tingtt/business-card/README.md

# taku-ting's business cards

- [modu-tone](./modu-tone/): modu-tone PCB business card
