tingtt/business-card/case/case.3mf

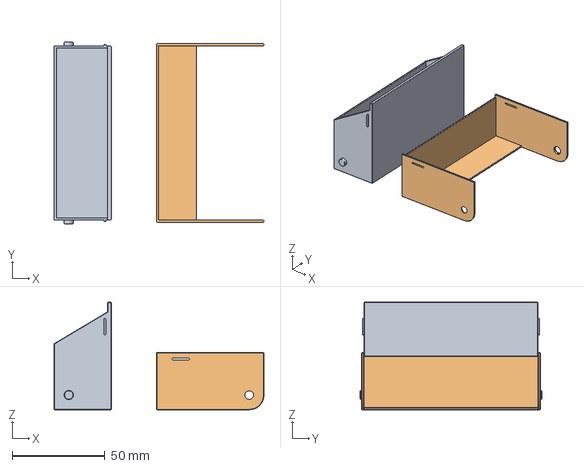
[picture p1: CAD file, 2026-08-08]
case/case.3mf
113.5 x 98.2 x 58.2 mm
case.stl
cover.stl
