tingtt/business-card/holder/card_holder.3mf

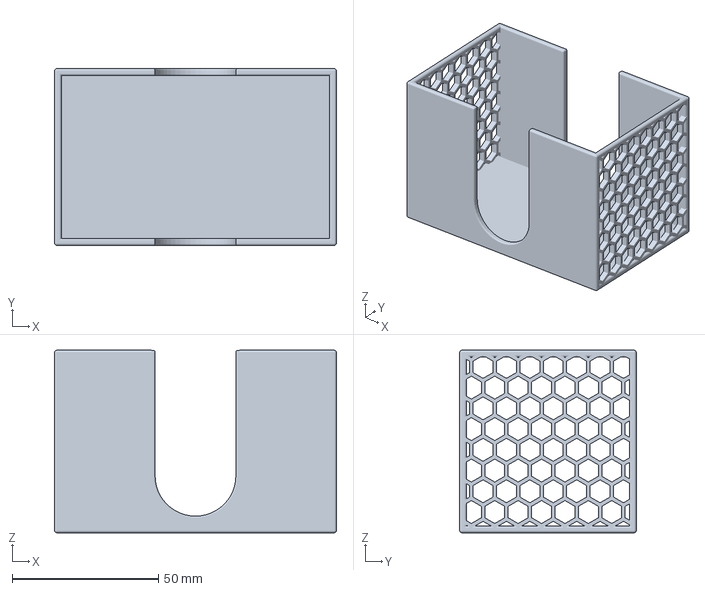
[picture p2: CAD file, 2026-07-26]
holder/card_holder.3mf
96.4 x 60.4 x 62.4 mm
