tingtt/business-card/modu-tone/business-card.step

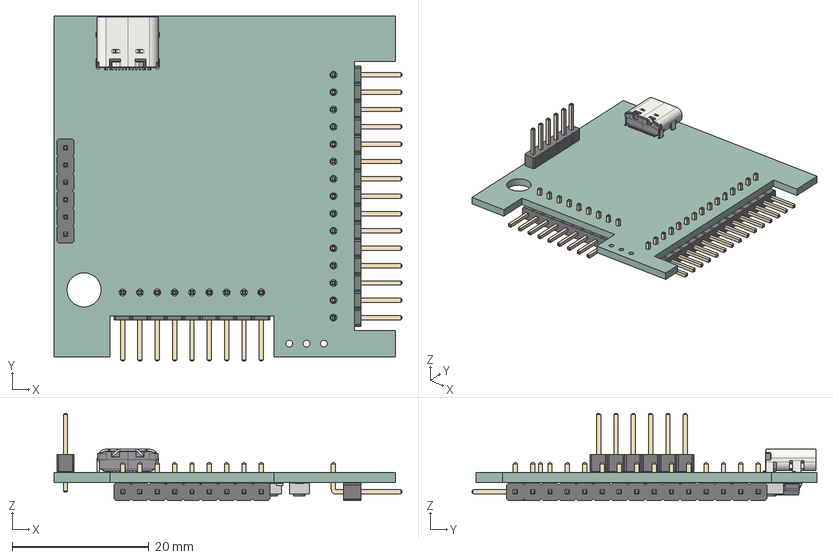
[picture p3: CAD file, 2026-07-18]
modu-tone/business-card.step
51.0 x 50.5 x 12.8 mm
PinHeader_1x06_P2.54mm_Vertical
USB_C_Receptacle_GCT_USB4105-xx-A_16P_TopMnt_Horizontal
C_0402_1005Metric x 16
SOT-223
USON-10_2.5x1.0mm_P0.5mm
D_SOD-523
R_0402_1005Metric x 11
Crystal_SMD_3225-4Pin_3.2x2.5mm
SOIC-8_5.3x5.3mm_P1.27mm
PinHeader_1x15_P2.54mm_Horizontal
TS-1088R-02026 x 2
QFN-56-1EP_7x7mm_P0.4mm_EP3.2x3.2mm
PinHeader_1x09_P2.54mm_Horizontal
base_PCB
