tingtt/business-card/modu-tone/business-card.kicad_pcb

## KiCad design modu-tone/business-card.kicad_pcb (2026-07-18)

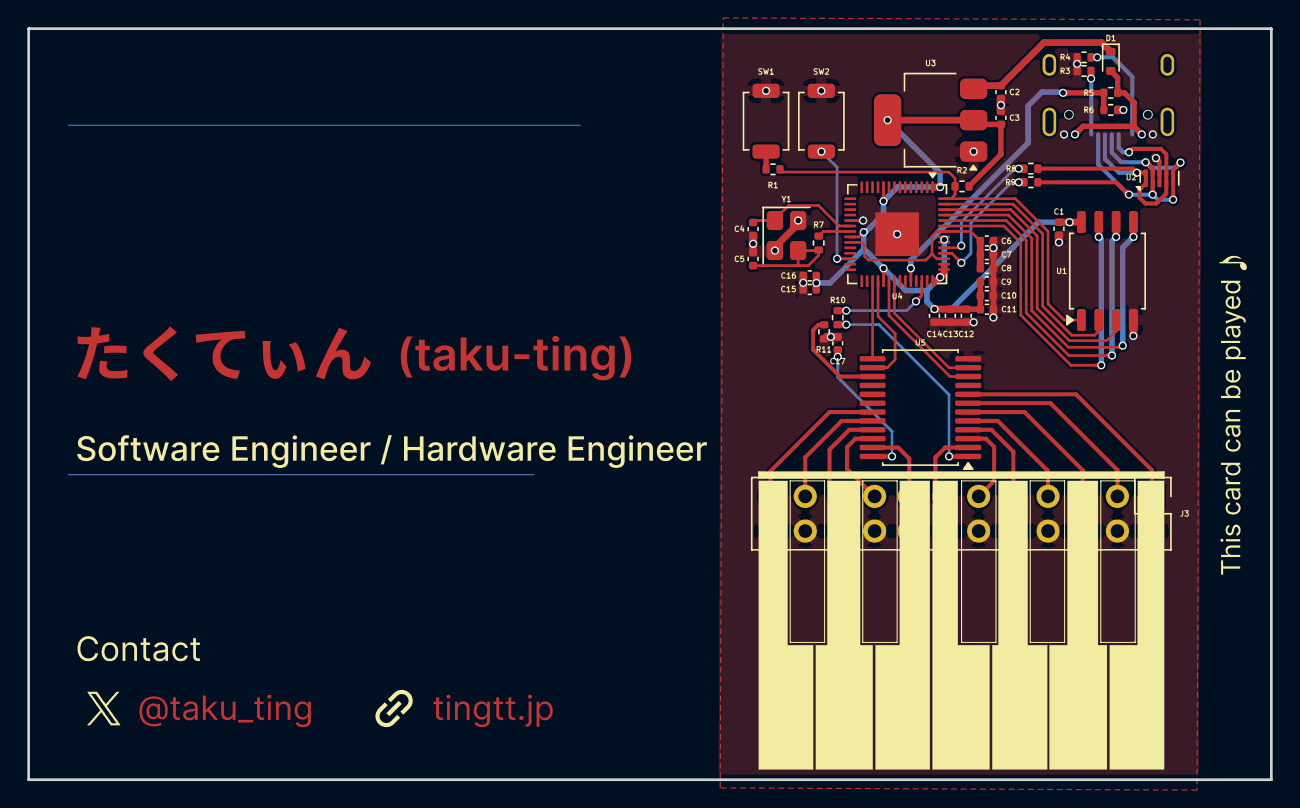
[picture p4: board business-card.kicad_pcb from above]

Board: 2 copper layers, 91.0 x 55.0 mm, 39 parts (1 on the bottom side), 43 nets.

Parts:
C1, C7, C10: 1u; C_0402_1005Metric
C2, C3: 10u; C_0402_1005Metric
C4, C5: 27p; C_0402_1005Metric
C6, C8, C9, C11, C12, C13, C14, C15, C16, C17: 100n; C_0402_1005Metric
D1: RB521S30T1G; D_SOD-523
J1: USB_C_Receptacle_USB2.0_16P; USB_C_Receptacle_HRO_TYPE-C-31-M-12
J3: Conn_02x12; PinHeader_2x12_P2.54mm_Vertical
R1, R7: 1k; R_0402_1005Metric
R2, R11: 10k; R_0402_1005Metric
R3, R4: 5.1k; R_0402_1005Metric
R5: 5.6k; R_0402_1005Metric
R6: 10K; R_0402_1005Metric
R8, R9: 27; R_0402_1005Metric
R10: 100; R_0402_1005Metric
SW1, SW2: TS-1088R-020; SW_SPST_TS-1088-xR020
U1: W25Q128JVS; SOIC-8_5.3x5.3mm_P1.27mm
U2: TPD4E05U06DQAR; USON-10_2.5x1.0mm_P0.5mm
U3: NCP1117LPST33T3G; SOT-223-3_TabPin2
U4: RP2040; QFN-56-1EP_7x7mm_P0.4mm_EP3.2x3.2mm
U5: CD74HC4067PW; SSOP-24_5.3x8.2mm_P0.65mm
Y1: 12MHz 18pF; Crystal_SMD_3225-4Pin_3.2x2.5mm

Connections:
+1V1: C6.1, C7.1, C8.1, U4.23 (DVDD), U4.45 (VREG_VOUT), U4.50 (DVDD)
+3V3: C1.1, C3.1, C9.1, C10.1, C11.1, C12.1, C13.1, C14.1, C15.1, C16.1, R2.2, U1.8 (VCC), U3.2 (VO), U4.1 (IOVDD), U4.10 (IOVDD), U4.22 (IOVDD), U4.33 (IOVDD), U4.42 (IOVDD), U4.43 (ADC_AVDD), U4.44 (VREG_IN), U4.48 (USB_VDD), U4.49 (IOVDD)
+5V: C2.1, D1.1 (K), U3.3 (VI)
/Key scan ADC: R10.2, U4.40 (GPIO28_ADC2)
/Key scan MUX S0: U4.31 (GPIO20), U5.13 (S3)
/Key scan MUX S1: U4.32 (GPIO21), U5.14 (S2)
/Key scan MUX S2: U4.34 (GPIO22), U5.10 (S0)
/Key scan MUX S3: U4.35 (GPIO23), U5.11 (S1)
GND: C1.2, C2.2, C3.2, C4.2, C5.2, C6.2, C7.2, C8.2, C9.2, C10.2, C11.2, C12.2, C13.2, C14.2, C15.2, C16.2, C17.1, J1.A1 (GND), J1.A12 (GND), J1.B1 (GND), J1.B12 (GND), J3.2, J3.4, J3.6, J3.8, J3.10, J3.12, J3.14, J3.16, J3.18, J3.20, J3.22, J3.24, R3.1, R4.1, R6.2, R11.1, SW1.1, SW2.1, U1.4 (GND), U2.3 (GND), U2.8 (GND), U3.1 (GND), U4.19 (TESTEN), U4.57 (GND), U5.12 (GND), Y1.2, Y1.4
unnamed: C5.1, R7.1, Y1.3
unnamed: J1.A5 (CC1), R3.2
unnamed: J1.B5 (CC2), R4.2
unnamed: J3.1, U5.8 (I1)
unnamed: J3.3, U5.7 (I2)
unnamed: J3.5, U5.6 (I3)
unnamed: J3.7, U5.5 (I4)
unnamed: J3.9, U5.4 (I5)
unnamed: J3.11, U5.3 (I6)
unnamed: J3.13, U5.2 (I7)
unnamed: J3.15, U5.23 (I8)
unnamed: J3.17, U5.22 (I9)
unnamed: J3.19, U5.21 (I10)
unnamed: J3.21, U5.20 (I11)
unnamed: J3.23, U5.19 (I12)
unnamed: R1.2, SW1.2
unnamed: SW2.2, U4.26 (RUN)
unnamed: R9.1, U4.46 (USB_DM)
unnamed: R8.2, U4.47 (USB_DP)
unnamed: C4.1, U4.20 (XIN), Y1.1
unnamed: R7.2, U4.21 (XOUT)
unnamed: R10.1, U5.1 (COM)
unnamed: C17.2, U5.24 (VCC)
unnamed: R11.2, U5.15 (~E)
QSPI_SCLK: U1.6 (CLK), U4.52 (QSPI_SCLK)
QSPI_SD0: U1.5 (DI/IO_{0}), U4.53 (QSPI_SD0)
QSPI_SD1: U1.2 (DO/IO_{1}), U4.55 (QSPI_SD1)
QSPI_SD2: U1.3 (~WP/IO_{2}), U4.54 (QSPI_SD2)
QSPI_SD3: U1.7 (~HOLD/~RESET/IO_{3}), U4.51 (QSPI_SD3)
QSPI_SS: R1.1, R2.1, U1.1 (~CS), U4.56 (QSPI_SS)
USB_DP_D+: J1.A6 (D+), J1.B6 (D+), R8.1, U2.1 (D1+), U2.4 (D2+), U2.7 (NC), U2.10 (NC)
USB_DP_D-: J1.A7 (D-), J1.B7 (D-), R9.2, U2.2 (D1-), U2.5 (D2-), U2.6 (NC), U2.9 (NC)
USB_VBUS: R5.2, R6.1, U4.38 (GPIO26_ADC0)
VBUS: D1.2 (A), J1.A4 (VBUS), J1.A9 (VBUS), J1.B4 (VBUS), J1.B9 (VBUS), R5.1
