tingtt/business-card/(commit log)

2026-07-18 add: modu-tone PCB business card
    [business-card.kicad_pcb, business-card.kicad_sch, business-card.step]
2026-07-26 feat(holder): add printable card holder model
    [card_holder.3mf, main.scad]
2026-08-03 add: business card case
    [case.3mf, case.scad, cover.scad, main.scad]
2026-08-08 feat(case): add rib-and-groove snap closure
    Why:
    The case needs a physical closing feature that holds shut when printed with the ZY face on the bed and layers running along X.
    What:
    - Replace the round connector peg and hole with vertical ribs on the case end faces.
    - Add matching vertical receiver grooves to the lid with a small bite for grip.
    - Regenerate the case print artifacts.
    Verification:
    - Ran `task scad:case:export`.
    - Rendered closed front, back, and right previews with OpenSCAD.
    [case.3mf, case.scad, cover.scad, main.scad]
